sk1ban312/Helios-Microgrid/fintech_and_business/README.md

# 📊 FinTech, Tokenomics & Business Model
**Project "Helios" — Venture Capital & Market Integration**





While the physical and digital engineering components of Helios demonstrate *how* the microgrid operates, this division outlines *why* it is economically viable at scale.

Led by our Financial and Quantitative Analysts, this section translates raw thermodynamics and IoT data into a comprehensive Venture Capital Investment Package.

## 📈 1. Financial Analysis (LCOE & ESG)
A robust 5-year financial model was developed to evaluate the scalability of the thermal cascade technology. The model includes:
* **Levelized Cost of Energy (LCOE):** Calculating the theoretical cost per kWh if the Stirling engine cascade is scaled to industrial manufacturing levels.
* **ESG Market Positioning:** Analyzing the environmental and social governance impact of deploying autonomous, heat-scavenging microgrids.
* **Political & Policy Impact:** Evaluated by our Political Science team to ensure compliance and viability within future global energy policy shifts.

👉 **[View the Complete Financial Model & Pitch Deck](https://gethelios.online/finance)**

## 🪙 2. Tokenomics & Quantitative Modeling ("Green Energy Certificate")
To integrate the microgrid into the modern decentralized energy trading market, we engineered a custom Tokenomics model. 
* **The Concept:** Every Watt of clean energy generated by the system can be minted into a "Green Energy Certificate" token.
* **Algorithmic Trading:** The model includes simulations for arbitrage strategies, allowing the system to theoretically trade excess generated power during peak grid demand.
* **Smart Contracts:** (Upcoming) Integration with Web3 networks to automate the issuance of tokens directly from Raspberry Pi IoT telemetry data.

👉 **[Read the Full Tokenomics Whitepaper](https://gethelios.online/token)**

---
*Developed by Simon Rakhlin (Lead Financial Analyst), Andrew Berks (Quantitative & FinTech Analyst), and Ava Amelio (Political Science Researcher).*
