sk1ban312/Helios-Microgrid/(commit log)

2026-03-31 Create README.md for hardware integration documentation
    Added comprehensive hardware documentation, including system architecture, Bill of Materials, and next steps for the Helios microgrid project.
2026-04-02 Enhance README with wiring architecture and sensor details
    Updated README to include microcontroller wiring architecture and sensor hub details for the Helios microgrid prototype.
2026-04-02 Rename с файлом README.md to README.md
